JitterCompany/piano-sensor/firmware-rtfm/README.md

# `Piano Sensor Firmware`

## Dependencies

To build cortex-m programs using you'll need:

- Rust 1.31, 1.30-beta, nightly-2018-09-13 or a newer toolchain. e.g. `rustup
  default beta`

- `rust-std` components (pre-compiled `core` crate) for the ARM Cortex-M
  targets. Run:

``` console
$ rustup target add thumbv6m-none-eabi thumbv7m-none-eabi thumbv7em-none-eabi thumbv7em-none-eabihf
```

4. Build the template application or one of the examples.

## Building

# Only First Time

To retrieve stm32f1xx-hal submodule

``` console
git submodule init
git submodule update
```

Build the application

``` console
$ cargo build
```

## Flashing

Using Bobbin:

```
bobbin load --bin firmware-rtfm
```

## Debugging

Command line GDB using Cargo:

```
cargo run
```

See .cargo/config for `runner` command.
