JitterCompany/piano-sensor/3D/piano.SLDASM

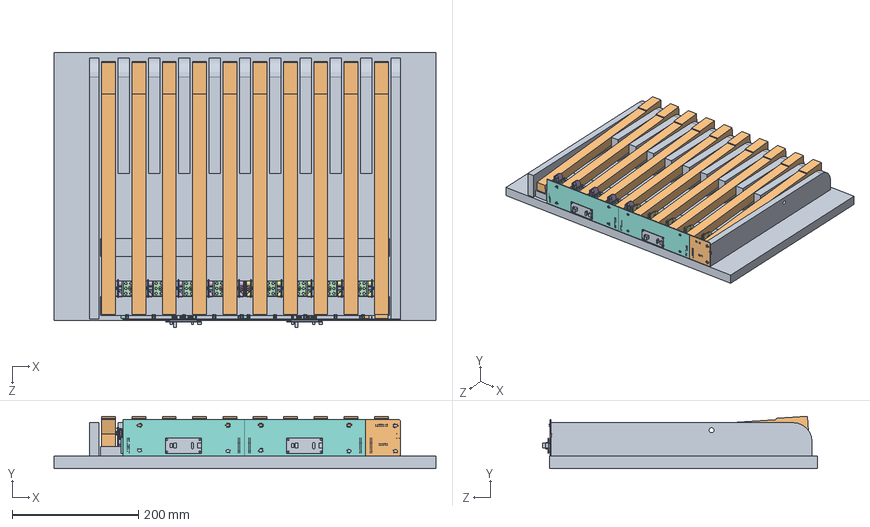
[picture p3: CAD file, 2019-10-30]
3D/piano.SLDASM
605.0 x 83.1 x 436.1 mm
piano_base
piano_key x 10
makeblock_slide_beam_0824-224 x 2
makeblock_bracket_3x3 x 10
socket button head cap screw_am x 10
encoder-breakout-right x 5
encoder-breakout-left x 5
main-board x 2
blackpill_mcu_board x 2
uart-adapter
