JitterCompany/piano-sensor/3D/main-board.SLDPRT

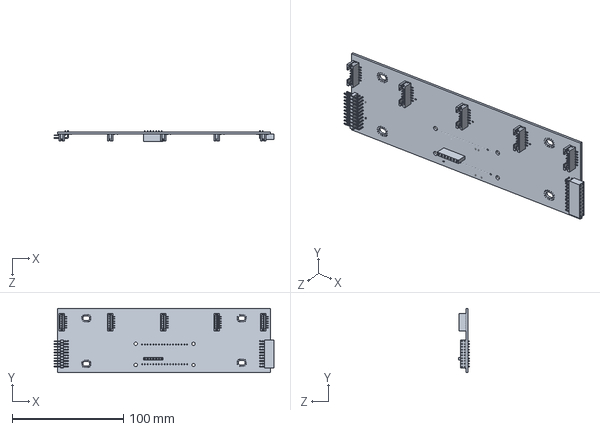
[picture p4: CAD file, 2019-10-09]
3D/main-board.SLDPRT
198.1 x 58.0 x 10.1 mm
