JitterCompany/piano-sensor/3D/piano_base.SLDPRT

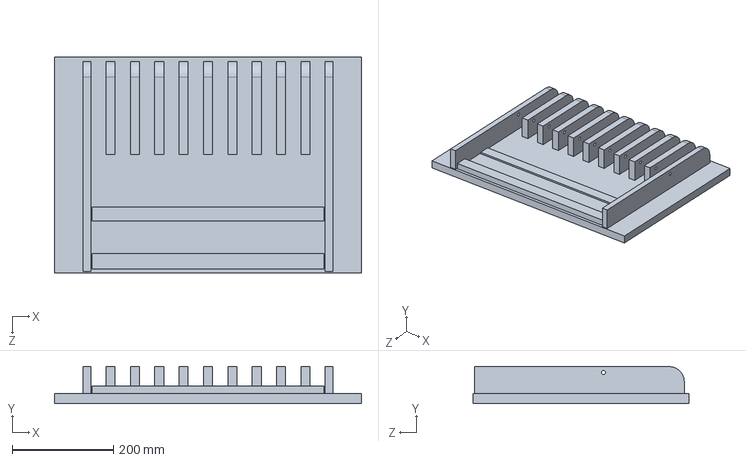
[picture p5: CAD file, 2019-10-30]
3D/piano_base.SLDPRT
605.0 x 73.0 x 425.0 mm
