JitterCompany/piano-sensor/3D/makeblock_bracket_3x3.SLDPRT

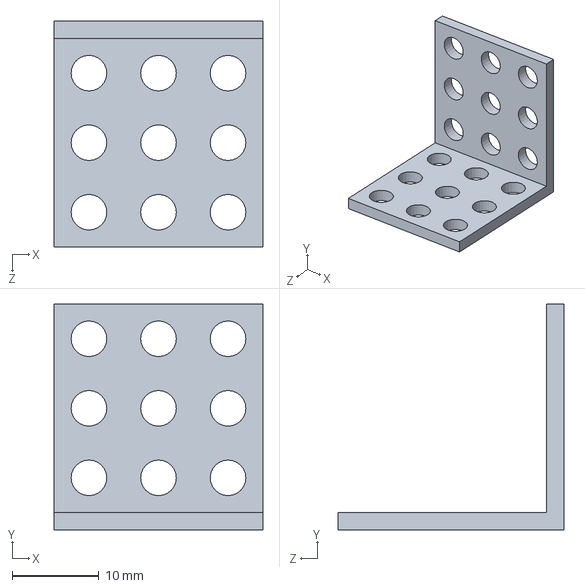
[picture p6: CAD file, 2019-10-09]
3D/makeblock_bracket_3x3.SLDPRT
24.0 x 26.0 x 26.0 mm
