JitterCompany/piano-sensor/3D/makeblock_slide_beam_0824-224.SLDPRT

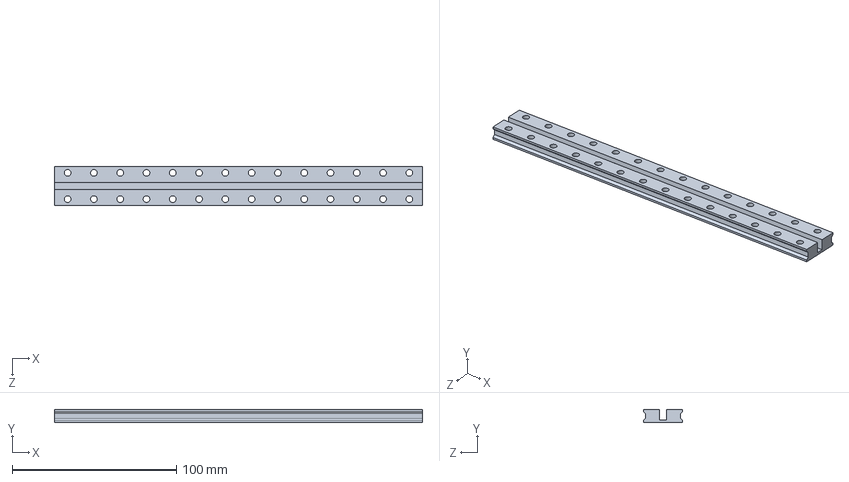
[picture p7: CAD file, 2019-10-09]
3D/makeblock_slide_beam_0824-224.SLDPRT
224.0 x 8.00 x 24.0 mm
