JitterCompany/piano-sensor/3D/encoder-breakout-left.SLDPRT

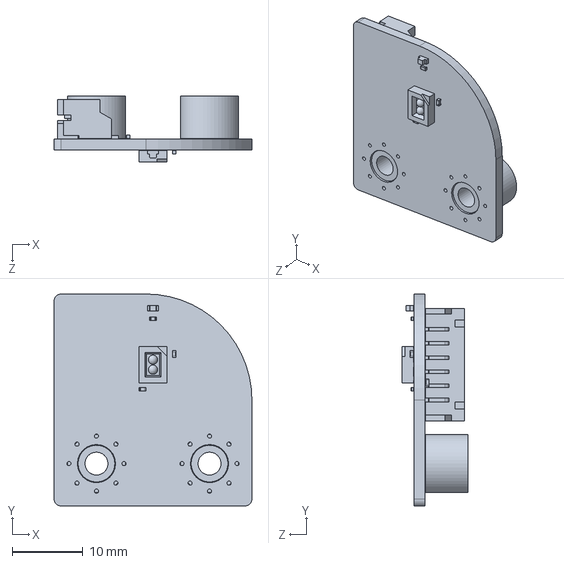
[picture p8: CAD file, 2019-10-09]
3D/encoder-breakout-left.SLDPRT
28.0 x 30.0 x 9.33 mm
