JitterCompany/piano-sensor/3D/uart-adapter.SLDPRT

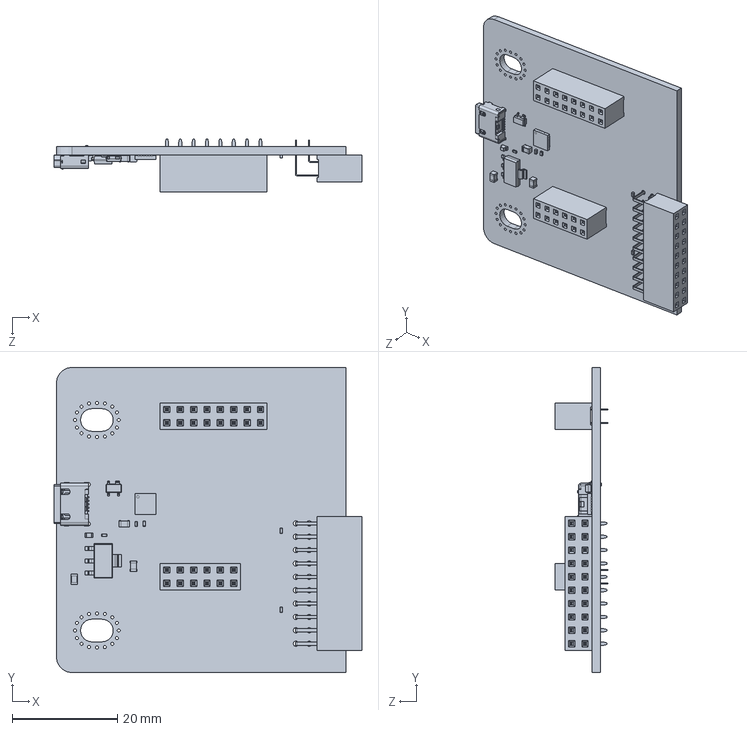
[picture p9: CAD file, 2019-10-09]
3D/uart-adapter.SLDPRT
58.5 x 58.0 x 10.1 mm
