JitterCompany/piano-sensor/3D/piano_key.SLDPRT

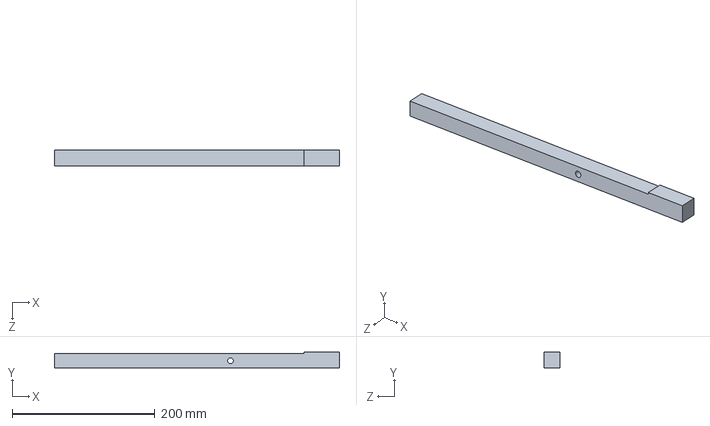
[picture p10: CAD file, 2019-10-09]
3D/piano_key.SLDPRT
400.0 x 22.2 x 22.0 mm
