JitterCompany/piano-sensor/3D/blackpill_mcu_board.SLDPRT

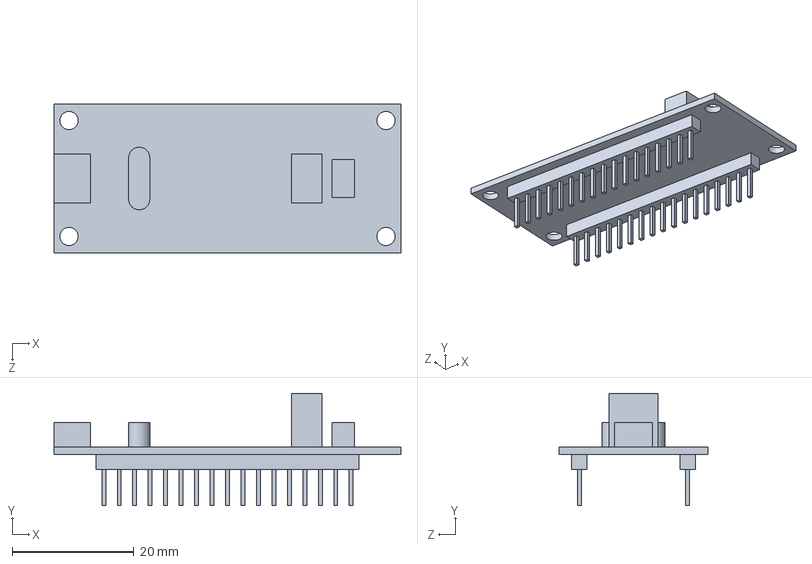
[picture p11: CAD file, 2019-10-09]
3D/blackpill_mcu_board.SLDPRT
57.0 x 18.4 x 24.4 mm
