JitterCompany/piano-sensor/(list of files, cad)

Other CAD files:
3D/encoder-breakout-right.SLDPRT
