JitterCompany/piano-sensor/firmware/src/main.rs

#![no_std]
#![no_main]

// pick a panicking behavior
extern crate panic_halt; // you can put a breakpoint on `rust_begin_unwind` to catch panics

use cortex_m_rt::entry;
use nb::block;

#[cfg(feature = "use_semihosting")]
#[macro_use]
#[cfg(feature = "use_semihosting")]
extern crate cortex_m_semihosting;
#[cfg(feature = "use_semihosting")]
use cortex_m_semihosting::{hprintln, hio};


extern crate stm32f1xx_hal;
use stm32f1xx_hal::{
    prelude::*, // auto import of most used stuff
    gpio::*, // gpio hal implementation for stm32f1xx
    timer,
    serial::{Config, Serial},
    pac::{self, interrupt, EXTI, USART2, USART3} // peripheral access crate (register access)
};

extern crate embedded_hal;
use embedded_hal::digital::v2::{OutputPin};

use core::{cell::RefCell, ops::DerefMut, cell::UnsafeCell};
use cortex_m::{interrupt::Mutex};

mod encoder;
use encoder::{Encoder, Channel};

mod counter;
use counter::CSCounter;


// workaround for issue https://github.com/stm32-rs/stm32f1xx-hal/issues/110 in stm32f1xx-hal
use core::fmt;
use::core::fmt::*;
struct FormatTx {
    tx :  stm32f1xx_hal::serial::Tx<USART2>,
}

impl fmt::Write for FormatTx {
    fn write_str(&mut self, s: &str) -> core::fmt::Result {
        s.as_bytes()
            .iter()
            .try_for_each(|c| nb::block!(self.tx.write(*c)))
            .map_err(|_| core::fmt::Error)
    }
}


struct FormatTx3 {
    tx :  stm32f1xx_hal::serial::Tx<USART3>,
}

impl fmt::Write for FormatTx3 {
    fn write_str(&mut self, s: &str) -> core::fmt::Result {
        s.as_bytes()
            .iter()
            .try_for_each(|c| nb::block!(self.tx.write(*c)))
            .map_err(|_| core::fmt::Error)
    }
}


// Make external interrupt registers globally available
static INT: Mutex<RefCell<Option<EXTI>>> = Mutex::new(RefCell::new(None));

// Make our LED globally available
static LED: Mutex<RefCell<Option<gpiob::PB12<Output<PushPull>>>>> = Mutex::new(RefCell::new(None));

static TIMER_UP: Mutex<RefCell<Option<timer::Timer<stm32f1xx_hal::pac::TIM1>>>> = Mutex::new(RefCell::new(None));

static TIME_MS: CSCounter<u32> = CSCounter(UnsafeCell::new(0));


static ENCODER1: Mutex<RefCell<Option<Encoder<
        gpioa::PA5<Input<PullUp>>,
        gpioc::PC13<Input<PullUp>>,
        gpiob::PB8<Output<PushPull>>
        >>>> = Mutex::new(RefCell::new(None));


static ENCODER2: Mutex<RefCell<Option<Encoder<
        gpioa::PA6<Input<PullUp>>,
        gpioa::PA12<Input<PullUp>>,
        gpioa::PA4<Output<PushPull>>
        >>>> = Mutex::new(RefCell::new(None));

static ENCODER3: Mutex<RefCell<Option<Encoder<
        gpioa::PA7<Input<PullUp>>,
        gpioa::PA11<Input<PullUp>>,
        gpiob::PB0<Output<PushPull>>
        >>>> = Mutex::new(RefCell::new(None));


static ENCODER4: Mutex<RefCell<Option<Encoder<
        gpioa::PA9<Input<PullUp>>,
        gpioa::PA10<Input<PullUp>>,
        gpiob::PB1<Output<PushPull>>
        >>>> = Mutex::new(RefCell::new(None));


static ENCODER5: Mutex<RefCell<Option<Encoder<
        gpioa::PA8<Input<PullUp>>,
        gpiob::PB15<Input<PullUp>>,
        gpiob::PB14<Output<PushPull>>
        >>>> = Mutex::new(RefCell::new(None));


#[entry]
fn main() -> ! {
    // #[cfg(feature = "use_semihosting")]
    // semihosting_print_example().ok();
    // Get access to the core peripherals from the cortex-m crate
    let cp = cortex_m::Peripherals::take().unwrap();
    // Get access to the device specific peripherals from the peripheral access crate
    let dp = pac::Peripherals::take().unwrap();

    let mut flash = dp.FLASH.constrain();

    let mut rcc = dp.RCC.constrain();

    // configure clocks
    let clocks = rcc.cfgr.use_hse(8.mhz()).sysclk(72.mhz()).pclk1(36.mhz()).freeze(&mut flash.acr);
    #[cfg(feature = "use_semihosting")] {
        hprintln!("sysclk freq: {}", clocks.sysclk().0).unwrap();
    }

    let mut gpioa = dp.GPIOA.split(&mut rcc.apb2);
    let mut gpiob = dp.GPIOB.split(&mut rcc.apb2);
    let mut gpioc = dp.GPIOC.split(&mut rcc.apb2);

    let mut led = gpiob.pb12.into_push_pull_output(&mut gpiob.crh);

    // turn on led (inverted logic)
    led.set_high().unwrap();

    led.set_low().unwrap();


    // input pin and interrupt setup
    // PA5 ChA, PA10 = ChB
    let pin_a5 = gpioa.pa5.into_pull_up_input(&mut gpioa.crl);
    let pin_a6 = gpioa.pa6.into_pull_up_input(&mut gpioa.crl);
    let pin_a7 = gpioa.pa7.into_pull_up_input(&mut gpioa.crl);
    let pin_a8 = gpioa.pa8.into_pull_up_input(&mut gpioa.crh);
    let pin_a9 = gpioa.pa9.into_pull_up_input(&mut gpioa.crh);
    let pin_a10 = gpioa.pa10.into_pull_up_input(&mut gpioa.crh);
    let pin_a11 = gpioa.pa11.into_pull_up_input(&mut gpioa.crh);
    let pin_a12 = gpioa.pa12.into_pull_up_input(&mut gpioa.crh);
    let pin_b15 = gpiob.pb15.into_pull_up_input(&mut gpiob.crh);
    let pin_c13 = gpioc.pc13.into_pull_up_input(&mut gpioc.crh);

    let mut afio = dp.AFIO.constrain(&mut rcc.apb2);

    // configure correct pins for external interrups
    afio.exticr2.exticr2().modify(|_,w| unsafe {
        w.exti5().bits(0b0000);  //PA5 1A
        w.exti6().bits(0b0000);  //PA6 2A
        w.exti7().bits(0b0000)   //PA7 3A
    });
    afio.exticr3.exticr3().modify(|_,w| unsafe {
        w.exti8().bits(0b0000);  //PA8 5A
        w.exti9().bits(0b0000);  //PA9 4A
        w.exti10().bits(0b0000); //PA10 4B
        w.exti11().bits(0b0000)  //PA11 3B
    });
     afio.exticr4.exticr4().modify(|_,w| unsafe {
        w.exti12().bits(0b0000); //PA12 2B
        w.exti15().bits(0b0001); //PB15 5B
        w.exti13().bits(0b0010)  //PC13 1B
    });



    //A bits 5,6,7,8,9
    //B bits 10,11,12,15,13

    let exti = dp.EXTI;

    // Set interrupt request masks; enable interrupts
    exti.imr.modify(|_, w| {
        w.mr5().set_bit();
        w.mr6().set_bit();
        w.mr7().set_bit();
        w.mr8().set_bit();
        w.mr9().set_bit();
        w.mr10().set_bit();
        w.mr11().set_bit();
        w.mr12().set_bit();
        w.mr15().set_bit();
        w.mr13().set_bit()
    });

    // Set interrupt falling and rising edge triggers
    exti.ftsr.modify(|_, w| {
        w.tr5().set_bit();
        w.tr6().set_bit();
        w.tr7().set_bit();
        w.tr8().set_bit();
        w.tr9().set_bit();
        w.tr10().set_bit();
        w.tr11().set_bit();
        w.tr12().set_bit();
        w.tr15().set_bit();
        w.tr13().set_bit()
    });
    exti.rtsr.modify(|_, w| {
        w.tr5().set_bit();
        w.tr6().set_bit();
        w.tr7().set_bit();
        w.tr8().set_bit();
        w.tr9().set_bit();
        w.tr10().set_bit();
        w.tr11().set_bit();
        w.tr12().set_bit();
        w.tr15().set_bit();
        w.tr13().set_bit()
    });

    // Enable the external interrupts for these lines in the NVIC.
    unsafe {
        pac::NVIC::unmask(pac::Interrupt::EXTI15_10);
        pac::NVIC::unmask(pac::Interrupt::EXTI9_5);
    }

    let mut timer = timer::Timer::syst(cp.SYST, 1000.hz(), clocks);
    let mut tim1 = timer::Timer::tim1(dp.TIM1, 1.khz(), clocks, &mut rcc.apb2);

    tim1.listen(timer::Event::Update);
    tim1.clear_update_interrupt_flag();


    //USART2_TX PA2
    //USART2_RX PA3
    let tx = gpioa.pa2.into_alternate_push_pull(&mut gpioa.crl);
    let rx = gpioa.pa3;

    let serial = Serial::usart2(
        dp.USART2,
        (tx, rx),
        &mut afio.mapr,
        Config::default().baudrate(115200.bps()),
        clocks,
        &mut rcc.apb1,
    );




    let ch1_led = gpiob.pb8.into_push_pull_output(&mut gpiob.crh);
    let ch2_led = gpioa.pa4.into_push_pull_output(&mut gpioa.crl);
    let ch3_led = gpiob.pb0.into_push_pull_output(&mut gpiob.crl);
    let ch4_led = gpiob.pb1.into_push_pull_output(&mut gpiob.crl);
    let ch5_led = gpiob.pb14.into_push_pull_output(&mut gpiob.crh);

    // ch1_led.set_high().unwrap();
    // ch2_led.set_high().unwrap();
    // ch3_led.set_high().unwrap();
    // ch4_led.set_high().unwrap();
    // ch5_led.set_high().unwrap();


    // Move control over LED and DELAY and EXTI into global mutexes
    cortex_m::interrupt::free(|cs| {
        *LED.borrow(cs).borrow_mut() = Some(led);
        *TIMER_UP.borrow(cs).borrow_mut() = Some(tim1);
        *INT.borrow(cs).borrow_mut() = Some(exti);

        // Create encoders inside mutexes to save stack memory. But maybe that is not really
        // necessary when optimize is enabled.
        *ENCODER1.borrow(cs).borrow_mut() = Some(Encoder::new(pin_a5, pin_c13, ch1_led));
        *ENCODER2.borrow(cs).borrow_mut() = Some(Encoder::new(pin_a6, pin_a12, ch2_led));
        *ENCODER3.borrow(cs).borrow_mut() = Some(Encoder::new(pin_a7, pin_a11, ch3_led));
        *ENCODER4.borrow(cs).borrow_mut() = Some(Encoder::new(pin_a9, pin_a10, ch4_led));
        *ENCODER5.borrow(cs).borrow_mut() = Some(Encoder::new(pin_a8, pin_b15, ch5_led));
    });

    let (tx, _) = serial.split();

    block!(timer.wait()).unwrap();
    let mut tx = FormatTx {
        tx: tx
    };
    writeln!(tx, "let's start! {}!", 12).unwrap();

    let uart3_tx = gpiob.pb10.into_alternate_push_pull(&mut gpiob.crh);
    let uart3_rx = gpiob.pb11;

    let serial_in = Serial::usart3(
        dp.USART3,
        (uart3_tx, uart3_rx),
        &mut afio.mapr,
        Config::default().baudrate(115200.bps()),
        clocks,
        &mut rcc.apb1,
    );

    let (in_tx, mut _in_rx) = serial_in.split();

    let mut in_tx = FormatTx3 {
        tx: in_tx
    };
    writeln!(in_tx, "Serial Input side!").unwrap();

    unsafe {
        pac::NVIC::unmask(pac::Interrupt::TIM1_UP);
        let mut nvic = cp.NVIC;
        nvic.set_priority(pac::Interrupt::TIM1_UP, 0); // prio 0
        nvic.set_priority(pac::Interrupt::EXTI15_10, 32); // prio 1
        nvic.set_priority(pac::Interrupt::EXTI9_5, 32); // prio 1
    }





    loop {

        // writeln!(in_tx, "Wait for input..").unwrap();

        // let received = block!(in_rx.read()).unwrap();
        // writeln!(in_tx, "Got: {}", received).unwrap();

        block!(timer.wait()).unwrap();

        cortex_m::interrupt::free(|cs| {
            if let Some(ref mut encoder) = ENCODER1.borrow(cs).borrow_mut().deref_mut() {
                if encoder.ready() {
                    let data = encoder.get();
                    writeln!(tx, "Start Encoder 1").unwrap();
                    for x in data {
                        unsafe {
                            writeln!(tx, "{}: {}", x.time, x.pos).unwrap();
                        }
                    }
                    writeln!(tx, "End").unwrap();
                    encoder.reset();

                }
            }

            if let Some(ref mut encoder) = ENCODER2.borrow(cs).borrow_mut().deref_mut() {
                if encoder.ready() {
                    let data = encoder.get();
                    writeln!(tx, "Encoder 2").unwrap();
                    for x in data {
                        unsafe {
                            writeln!(tx, "{}: {}", x.time, x.pos).unwrap();
                        }
                    }
                    encoder.reset();

                }
            }

            if let Some(ref mut encoder) = ENCODER3.borrow(cs).borrow_mut().deref_mut() {
                if encoder.ready() {
                    let data = encoder.get();
                    writeln!(tx, "Encoder 3").unwrap();
                    for x in data {
                        unsafe {
                            writeln!(tx, "{}: {}", x.time, x.pos).unwrap();
                        }
                    }
                    encoder.reset();

                }
            }

            if let Some(ref mut encoder) = ENCODER4.borrow(cs).borrow_mut().deref_mut() {
                if encoder.ready() {
                    let data = encoder.get();
                    writeln!(tx, "Encoder 4").unwrap();
                    for x in data {
                        unsafe {
                            writeln!(tx, "{}: {}", x.time, x.pos).unwrap();
                        }
                    }
                    encoder.reset();

                }
            }

            if let Some(ref mut encoder) = ENCODER5.borrow(cs).borrow_mut().deref_mut() {
                if encoder.ready() {
                    let data = encoder.get();
                    writeln!(tx, "Encoder 5").unwrap();
                    for x in data {
                        unsafe {
                            writeln!(tx, "{}: {}", x.time, x.pos).unwrap();
                        }
                    }
                    encoder.reset();

                }
            }
        });


    }
}

// fn poll_encoder() {

// }



#[interrupt]
fn TIM1_UP() {
    cortex_m::interrupt::free(|cs| {
        if let Some(ref mut tim1) = TIMER_UP.borrow(cs).borrow_mut().deref_mut() {
            tim1.clear_update_interrupt_flag();
            // count 1 millisecond
            TIME_MS.increment(cs);
        }
    });
}

/**
 *Ch A interrupt
 */
#[interrupt]
fn EXTI9_5() {
    encoder_isr(Channel::A);
}

/**
 *Ch B interrupt
 */
#[interrupt]
fn EXTI15_10() {
    encoder_isr(Channel::B);
}

fn encoder_isr(channel: Channel) {
    cortex_m::interrupt::free(|cs| {
        if let Some(ref mut exti) = INT.borrow(cs).borrow_mut().deref_mut() {

            let pr = exti.pr.read();
            let t: u32 = TIME_MS.get();

            if pr.pr5().bit_is_set() || pr.pr13().bit_is_set() {
                // Clear the interrupt flagw.
                exti.pr.write(|w| {
                    w.pr5().set_bit();
                    w.pr13().set_bit()
                });
                if let Some(ref mut encoder) = ENCODER1.borrow(cs).borrow_mut().deref_mut() {
                    encoder.update(&channel, t);
                }
            }
            if pr.pr6().bit_is_set() || pr.pr12().bit_is_set() {
                // Clear the interrupt flagw.
                exti.pr.write(|w| {
                    w.pr6().set_bit();
                    w.pr12().set_bit()
                });
                if let Some(ref mut encoder) = ENCODER2.borrow(cs).borrow_mut().deref_mut() {
                    encoder.update(&channel, t);
                }
            }
            if pr.pr7().bit_is_set() || pr.pr11().bit_is_set() {
                // Clear the interrupt flagw.
                exti.pr.write(|w| {
                    w.pr7().set_bit();
                    w.pr11().set_bit()
                });
                if let Some(ref mut encoder) = ENCODER3.borrow(cs).borrow_mut().deref_mut() {
                    encoder.update(&channel, t);
                }
            }
            if pr.pr9().bit_is_set() || pr.pr10().bit_is_set() {
                // Clear the interrupt flagw.
                exti.pr.write(|w| {
                    w.pr9().set_bit();
                    w.pr10().set_bit()
                });
                if let Some(ref mut encoder) = ENCODER4.borrow(cs).borrow_mut().deref_mut() {
                    encoder.update(&channel, t);
                }
            }
            if pr.pr8().bit_is_set() || pr.pr15().bit_is_set() {
                // Clear the interrupt flagw.
                exti.pr.write(|w| {
                    w.pr8().set_bit();
                    w.pr15().set_bit()
                });
                if let Some(ref mut encoder) = ENCODER5.borrow(cs).borrow_mut().deref_mut() {
                    encoder.update(&channel, t);
                }
            }

            // Change the LED state on each interrupt.
            if let Some(ref mut led) = LED.borrow(cs).borrow_mut().deref_mut() {
                led.toggle().unwrap();
            }

        }
    });
}


#[cfg(feature = "use_semihosting")]
fn semihosting_print_example() -> Result<(), core::fmt::Error> {

    hprintln!("Hello, rust world!").unwrap();

    const UUID: *mut u32 = 0x1FFF_F7E8 as *mut u32;
    dbg!(UUID);

    let mut uuid: [u32; 4] = [0; 4];
    for i in 0..4 {
        dbg!(i);
        uuid[i] = unsafe { dbg!(UUID.offset(i as isize).read_volatile()) };
    }

    let mut stdout = match hio::hstdout() {
        Ok(fd) => fd,
        Err(()) => return Err(core::fmt::Error),
    };

    let language = "Rust";
    let ranking = 1;

    write!(stdout, "{} on embedded is #{}!\n", language, ranking)?;

    Ok(())
}
