JitterCompany/piano-sensor/app/settings.py

# The default location the log files will be stored in
LOG_DIR = "logs/"

# The filename prefix for the logfiles. Files will be called $FILE_PREFIX_0, $FILE_PREFIX_1, $FILE_PREFIX_2 etc.
SUMMARY_FILE_PREFIX = "summary_data"
RAW_FILE_PREFIX = "raw_data"
