JitterCompany/piano-sensor/(commit log)

2019-09-18 Add basic firmware project that is compiles for the stm32f103
2019-09-20 Add debugging options
    - black magic probe
    - openocd
    [jtag-lock-pick_tiny2_swd.cfg]
2019-09-20 Semihosting example: print data to host in different ways
    - hprintln
    - dbg! macro (very slow, but useful)
    - write!() in combination with core::fmt
2019-09-20 Add pin interrupts that trigger on fallinig edge
    These two pins are connected to the A and B channel of the optical
    encoder.
    For now we only blink a led in the interrupt routine, however the next
    step is to keep the encoder count
2019-09-21 Implement basic encoder reader.
    However looks like we're missing interrupts. It is not keeping up yet
    with arduino.
    While arduino counts between 0 and -138, our rust code only counts from
    0 to -71. So that's a suspicious factor 2..
    [main.rs]
2019-09-21 Also enable interrupts on falling edges for beter resolution
    Now it doesn't seem to miss interrupts since it goes back to count == 0
    [main.rs]
2019-09-24 Use Timer1 to keep time in millisecond resolution
    The timer is configured at 1kHz, so every overflow we count 1
    millisecond in a thread safe counter object (CSCounter).
2019-09-24 Implement Encoder struct that records the position data for 1 keypress
    After the keypress is finished t will output the data to be sent over
    serial
2019-09-24 Move encoder implementation to its own file
2019-09-25 Refactor: move embedded)hal InputPins to encoder implementation
    This commit contains a lot of new (for us) concepts in Rust
    - using Generic types in CSCounter and Encoder
    - using Traits as generic types
    - using match to handle Result type or enum switch case
    It is a good step towards having multiple encoders at the same time.
2019-09-26 Add workaround for printing formatted string over serial
    See issue https://github.com/stm32-rs/stm32f1xx-hal/issues/110 in stm32f1xx-hal
    When it is fixed we can remove the workaround FormatTx wrapper and just
    use tx directly
    [counter.rs, main.rs]
2019-09-26 Configure pins for 5 encoders
    Memory is limited so no more than 200 samples per channel can be saved
    for now.
2019-09-26 Add more encoders in mutexes
    There is still a problem if we enable all encoders. Probably out of
    memory?
    [encoder.rs, main.rs]
2019-09-30 Make encoder data more efficient and packed.
    Now we can fit 5 encoders in memory.
    Also we create the encoders directly in the Mutex so we don't use the
    memory twice. Not sure why that memory is not freed after the move.
2019-10-01 Fix stack overflow issues by optimizing Encoder init and set opt=1
    In opt=0 the compiler does not seem to clean up any stack. So we run
    into problems really soon.
    [encoder.rs, main.rs]
2019-10-01 Add left and right version for encoder breakouts
    Routed PCBs.
    [encoder-breakout-left.kicad_pcb, encoder-breakout-right.kicad_pcb, encoder-breakout.sch]
2019-10-01 Update encoder with 3d footprint
    [encoder-breakout-left.kicad_pcb, encoder-breakout-right.kicad_pcb, encoder-breakout.sch]
2019-10-02 Add trial component placement for main-pcb
    [main-board.kicad_pcb, main-board.sch]
2019-10-03 Route main board. Pre design check version
    [main-board.kicad_pcb, main-board.sch]
2019-10-03 Breakout PCBs: update footprints from library
    [encoder-breakout-left.kicad_pcb, encoder-breakout-right.kicad_pcb]
2019-10-03 Main PCB: update footprints from library
    [main-board.kicad_pcb]
2019-10-04 Add uart-adapter board (WIP)
    [uart-adapter.kicad_pcb, uart-adapter.sch]
2019-10-04 Fix mounting holes in main-pcb and finish uart routing
    [main-board.kicad_pcb, uart-adapter.kicad_pcb, uart-adapter.sch]
2019-10-04 Fix DRC and add silk layer text and details and logos
    [encoder-breakout-left.kicad_pcb, encoder-breakout-right.kicad_pcb, main-board.kicad_pcb]
2019-10-04 Also route status led signals for all encoders
    [main-board.kicad_pcb, main-board.sch]
2019-10-04 Add optional LEDs for each channel on main board.
    Maybe the main board is better visible than the encoder breakouts
    [main-board.kicad_pcb, main-board.sch]
2019-10-04 Add text comments to main schematics
    [main-board.sch]
2019-10-04 Add LED MPN information. add power led to UART board
    [encoder-breakout.sch, main-board.kicad_pcb, main-board.sch, uart-adapter.kicad_pcb, uart-adapter.sch]
2019-10-09 Fix schematics compile errors
    [encoder-breakout.sch, main-board.sch, uart-adapter.kicad_pcb, uart-adapter.sch]
2019-10-09 Create tooling frames for pcbs
    [encoder-breakout-frame.kicad_pcb, encoder-breakout-right.kicad_pcb, main-board.kicad_pcb, main-board.sch, uart-adapter.kicad_pcb, uart-adapter.sch]
2019-10-09 Replace tooling holes with dual sided version
    [encoder-breakout-frame.kicad_pcb]
2019-10-09 UART adapter: move mounting holes
    [uart-adapter.kicad_pcb]
2019-10-09 Add 3D design files
    [blackpill_mcu_board.SLDPRT, encoder-breakout-left.SLDPRT, encoder-breakout-right.SLDPRT, main-board.SLDPRT, makeblock_bracket_3x3.SLDPRT, makeblock_slide_beam_0824-224.SLDPRT, piano.SLDASM, piano_base.SLDPRT]
2019-10-10 Force sensor mainboard: small layout improvments, all PCBs now production ready
    [main-board.kicad_pcb]
2019-10-11 UART adapter: production ready
    [uart-adapter.kicad_pcb, uart-adapter.sch]
2019-10-28 Update pinmapping for new PCBs
2019-10-29 Add status led pins for each channel and USART3 for input
2019-10-30 Add status led pins t encoders
2019-10-30 Encoder breakout V2: sensor was rotated incorrectly!
    [encoder-breakout-frame.kicad_pcb, encoder-breakout-left.kicad_pcb, encoder-breakout-right.kicad_pcb, encoder-breakout.sch]
2019-10-30 encoder_breakout: add symlinks to shared schematics
    [encoder-breakout-left.sch, encoder-breakout-right.sch]
2019-10-30 Update 3D files
    [piano.SLDASM, piano_base.SLDPRT]
2019-11-01 Base SerialManager on serial/tools/miniterm.py
    Add reader thread
2019-11-05 Show encoder number, accel and rise time after key press
2019-11-18 WIP: port app to rtfm framework
2019-11-19 Basic encoder -> uart example using software tasks
    However it seems that the rtfm framework does not like large buffers in
    shared resources. It claims double the buffer size on stack
    during/before init? Not sure yet why
2019-11-19 Add time in ms to encoder data
2019-11-19 Improve robustness of dataset detection (debouncing)
    We try to make sure that a dataset is only submitted when it is a nicely
    increasing set. We try to filter out all bounces of the piano keys.
2019-11-19 Fix some compiler warnings
    [encoder.rs, main.rs]
2019-11-19 First try 5 encoders at the same time.
    Low level seems good. Higher level still mixing up data.
2019-11-20 Prevent multiple encoders interfering with each other.
    First come first serve. The first encoder claims the 'ACTIVE_ENCODER'
    state. Until this one is done, other encoders will be ignored.
    [encoder.rs, main.rs]
2019-11-20 Add header with encoder number to data set output
2019-11-20 clean up encoder.rs
2019-11-20 Add serial throughput UART3_Rx -> UART2_Tx
    For now the baudrate is configured at 57.6k, with a maximum line length
    of 12 bytes to prevent overrun erros.
    It might be better to use DMA so we can buffer more data and limit the
    number of interrupts. But for now it works.
    [encoder.rs, main.rs]
2019-11-20 Add 5 to external encoder index
2019-11-21 Change priorities of send and buffer tasks
    buffer tasks should be higher than send task, so they don't get blocked
    by the slow uart.
2019-11-21 Print formatted data in milliseconds and mm/s to text output
2019-11-21 add stm32f1xx-hal as submodule
2019-11-21 Add startup task with led animation
2019-11-21 Remove print statement that prints all data to terminal
2019-11-22 Write summary to log file instead of all data.
    Todo: log separate file with raw encoder data
2019-12-02 Add encoder reset command
    firmware listens on uart2 for external commands. When it receives
    'reset' it will zero all encoders and reset all state.
    This can be used when encoders get in a wrong state/offset due to
    missing encoder lines for example.
    [encoder.rs, main.rs]
2019-12-02 Add serial command to retrieve current encoder counts
    Add buttons in app to send these commands. Response will be added to
    logfiles as comment
2019-12-02 Add sysreset command to reset entire mcu.
    Use rtfm scheduler api to run reset command in the future so that the
    sysreset command has time to be sent to the next board in the chain.
    [comports.py, main.rs]
2019-12-02 add sysreset cmd to app. reset -> sysreset, zero -> encoder reset
    [app.py, views.py]
